AJMartel/Grove_LoRa_433MHz_and_915MHz_RF/Schematics/LoRa Radio 915MHz v1.0.brd

## EAGLE design Schematics/LoRa Radio 915MHz v1.0.brd (2019-04-16)

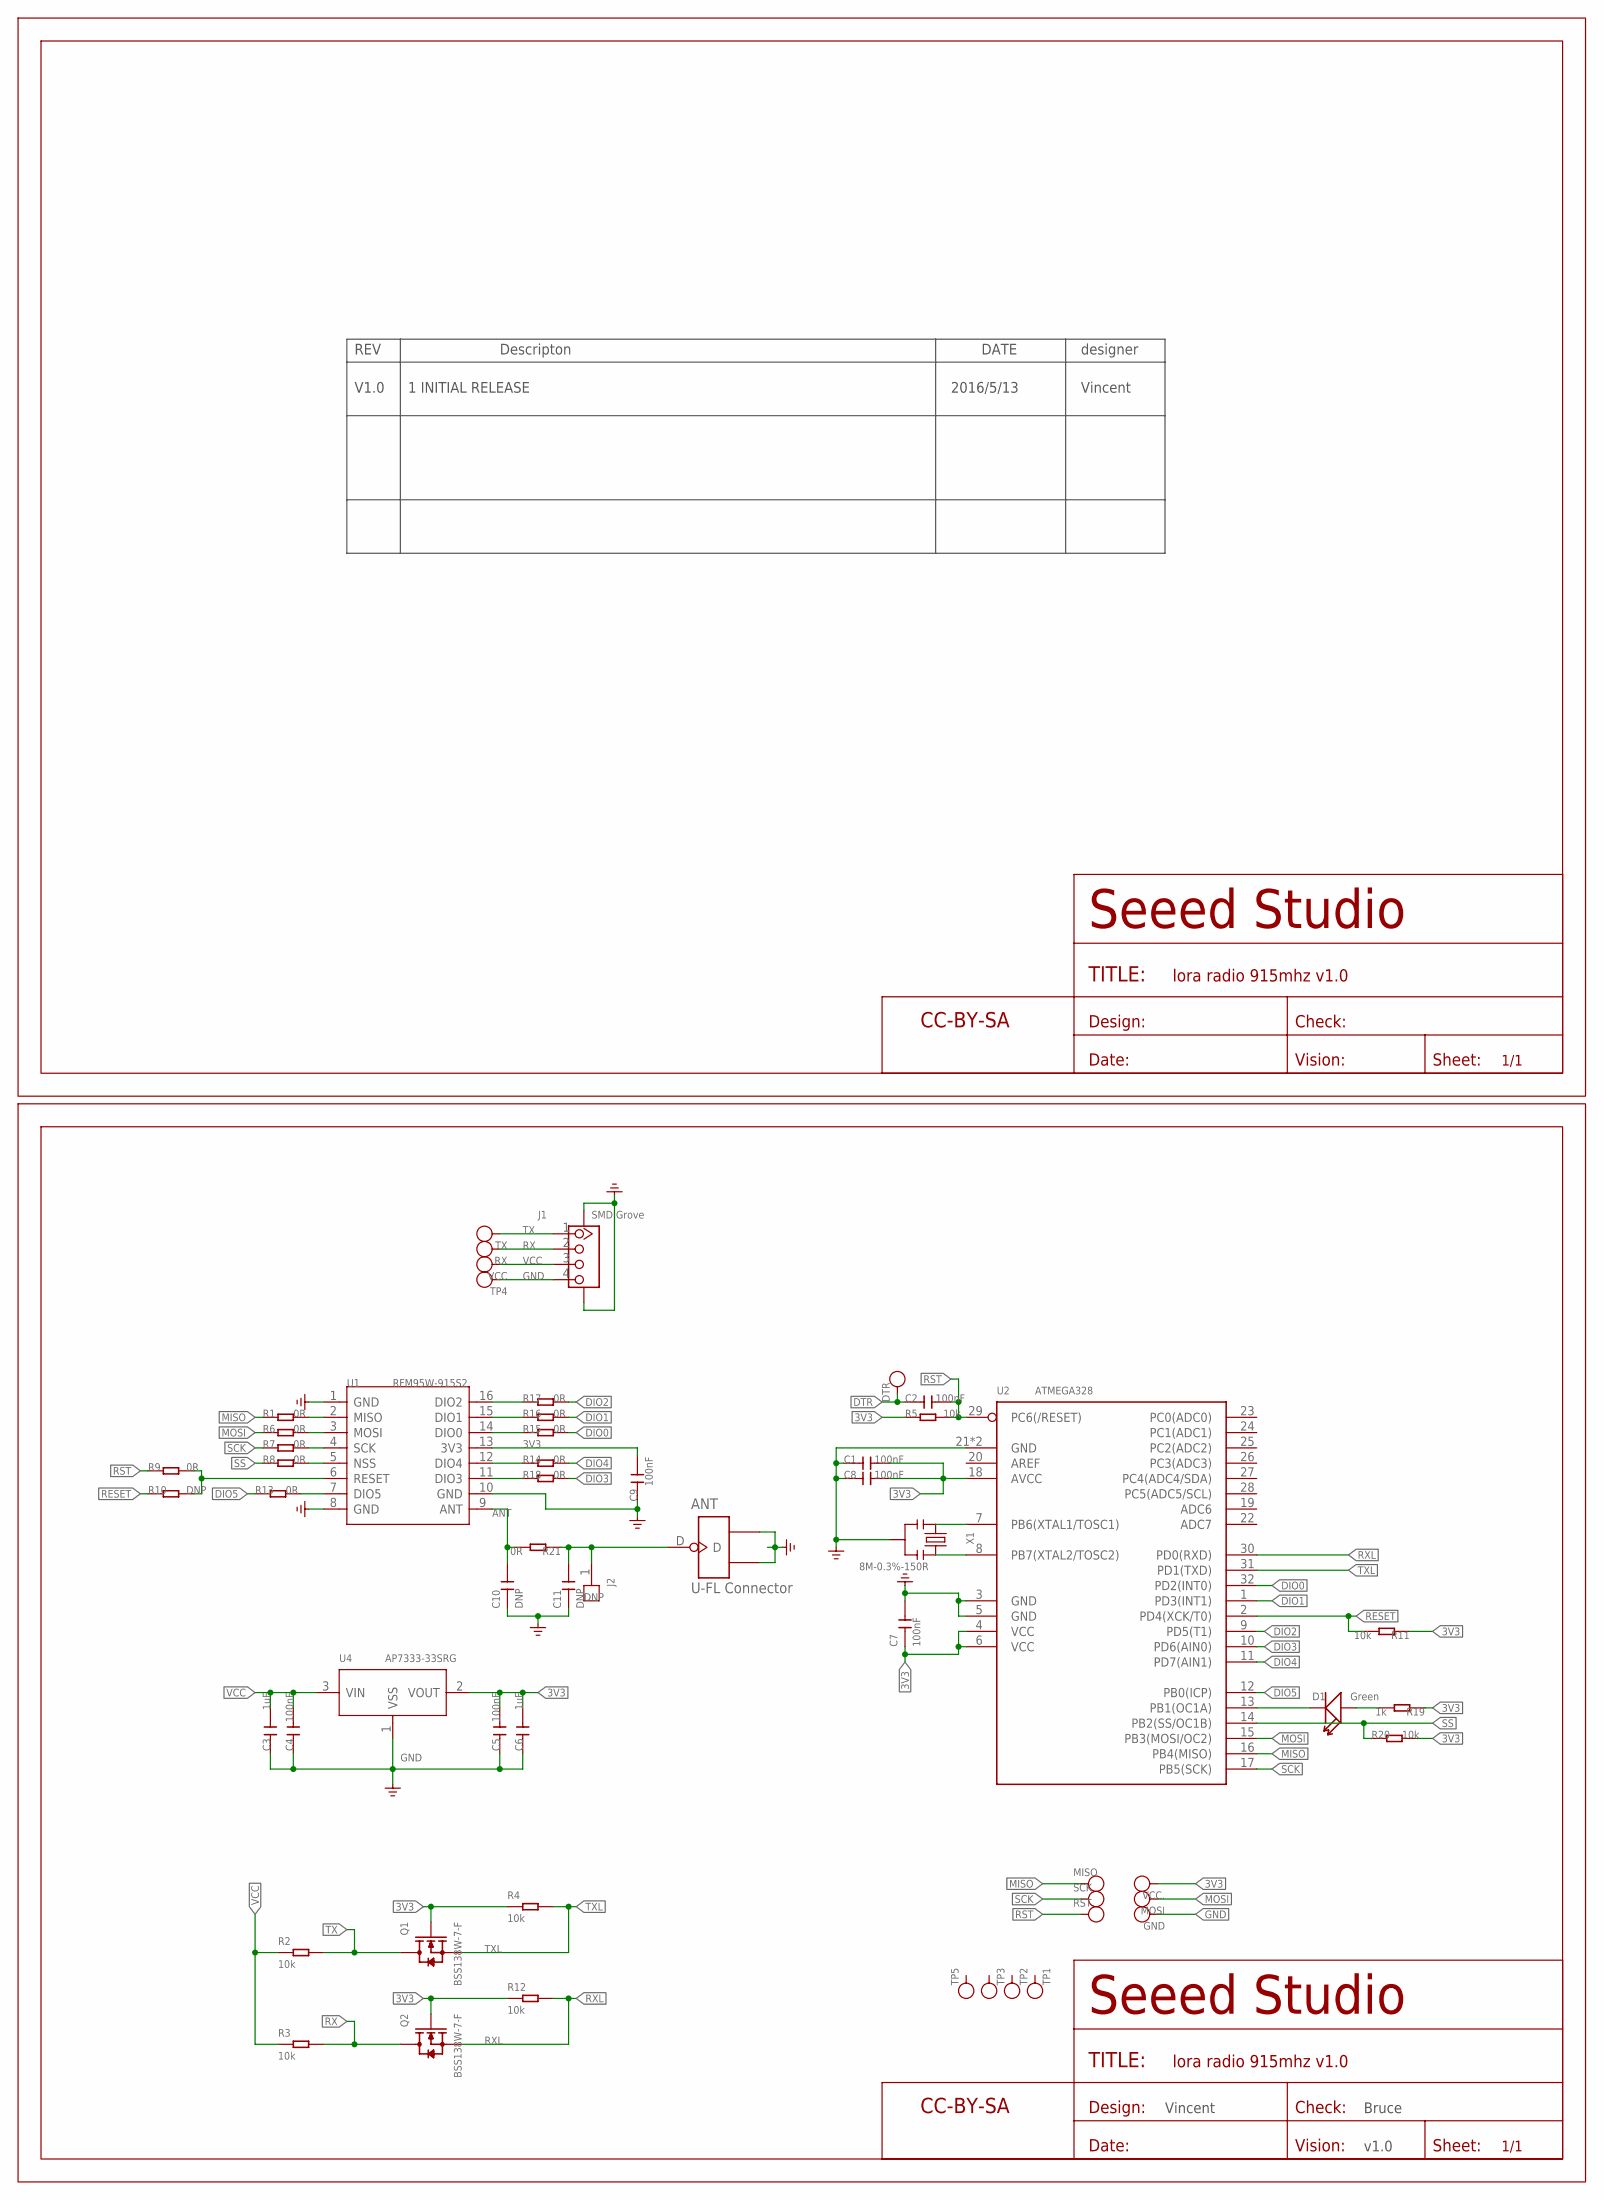
[picture p1: schematic LoRa Radio 915MHz v1.0.sch]

Parts:
ANT: U-FL Connector; U-FL3P-SMD-2.6X2.6X1.0MM
C1, C2, C4, C5, C7, C8, C9: 100nF; C0402
C3, C6: 1uF; C0402
C10, C11: DNP; C0402
D1: Green; LED-0402
DTR: TEST-POINT'4545'; TP-D45MIL
FR1, FR2: SEEEDSTUDIO-OPEN-SCH-FRAME; SEEEDSTUDIO-PCB-FRAME
GND: DNP; TP-D45MIL
J1: SMD Grove; HW4-SMD-2.0
J2: DNP; 1P-65/35MIL
MISO: DNP; TP-D45MIL
MOSI: DNP; TP-D45MIL
Q1, Q2: BSS138W-7-F; SOT-323
R1, R6, R7, R8, R9, R13, R14, R15, R16, R17, R18: 0R; R0402
R2, R3, R4, R5, R11, R12, R20: 10k; R0402
R10: DNP; R0402
R19: 1k; R0402
R21: 0R; R0603
RST: DNP; TP-D45MIL
RX: TEST-POINT'4545'; TP-D45MIL
SCK: DNP; TP-D45MIL
TP1, TP2, TP3, TP4, TP5: TEST-POINT'4545'; TP-D45MIL
TX: TEST-POINT'4545'; TP-D45MIL
U1: RFM95W-915S2; MODEM16-2-16X16X1.8MM
U2: ATMEGA328; QFN32G-0.5-5X5MM
U4: AP7333-33SRG; SOT-23
VCC: TEST-POINT'4545'; TP-D45MIL
VCC.: NC; TP-D45MIL
X1: 8M-0.3%-150R; RESONATOR3-SMD-3.6X1.3X0.8MM

Connections:
3V3: C1.2, C5.1, C6.1, C7.1, C8.2, C9.2, Q1.1 (G), Q2.1 (G), R4.1, R5.2, R11.2, R12.1, R19.2, R20.2, U1.13 (3V3), U2.4 (VCC), U2.6 (VCC), U2.18 (AVCC), U4.2 (VOUT), VCC..T
ANT: C10.2, R21.2, U1.9 (ANT)
DIO0: R15.2, U2.32 (PD2(INT0))
DIO1: R16.2, U2.1 (PD3(INT1))
DIO2: R17.2, U2.9 (PD5(T1))
DIO3: R18.2, U2.10 (PD6(AIN0))
DIO4: R14.2, U2.11 (PD7(AIN1))
DIO5: R13.1, U2.12 (PB0(ICP))
DTR: C2.1, DTR.T
GND: ANT.GND1, ANT.GND2, C1.1, C3.2, C4.2, C5.2, C6.2, C7.2, C8.1, C9.1, C10.1, C11.1, GND.T, J1.4, J1.SS1, J1.SS2, TP4.T, U1.1 (GND), U1.8 (GND), U1.10 (GND), U2.3 (GND), U2.5 (GND), U2.21 (GND), U2.33 (GND), U4.1 (VSS), X1.2
MISO: MISO.T, R1.1, U2.16 (PB4(MISO))
MOSI: MOSI.T, R6.1, U2.15 (PB3(MOSI/OC2))
unnamed: R13.2, U1.7 (DIO5)
unnamed: R17.1, U1.16 (DIO2)
unnamed: R9.1, R10.1, U1.6 (RESET)
unnamed: R16.1, U1.15 (DIO1)
unnamed: R15.1, U1.14 (DIO0)
unnamed: R14.1, U1.12 (DIO4)
unnamed: R1.2, U1.2 (MISO)
unnamed: R6.2, U1.3 (MOSI)
unnamed: R7.2, U1.4 (SCK)
unnamed: R8.2, U1.5 (NSS)
unnamed: R18.1, U1.11 (DIO3)
unnamed: D1.-, U2.13 (PB1(OC1A))
unnamed: D1.+, R19.1
unnamed: ANT.D, C11.2, J2.1, R21.1
RESET: R10.2, R11.1, U2.2 (PD4(XCK/T0))
RST: C2.2, R5.1, R9.2, RST.T, U2.29 (PC6(/RESET))
RX: J1.2, Q2.3 (D), R3.2, RX.T
RXL: Q2.2 (S), R12.2, U2.30 (PD0(RXD))
SCK: R7.1, SCK.T, U2.17 (PB5(SCK))
SS: R8.1, R20.1, U2.14 (PB2(SS/OC1B))
TX: J1.1, Q1.3 (D), R2.2, TX.T
TXL: Q1.2 (S), R4.2, U2.31 (PD1(TXD))
VCC: C3.1, C4.1, J1.3, R2.1, R3.1, U4.3 (VIN), VCC.T
XTAL1: U2.7 (PB6(XTAL1/TOSC1)), X1.1
XTAL2: U2.8 (PB7(XTAL2/TOSC2)), X1.3

Notes on the sheet:
REV
Descripton
DATE
designer
V1.0
1 INITIAL RELEASE
2016/5/13
Vincent
Bruce
v1.0

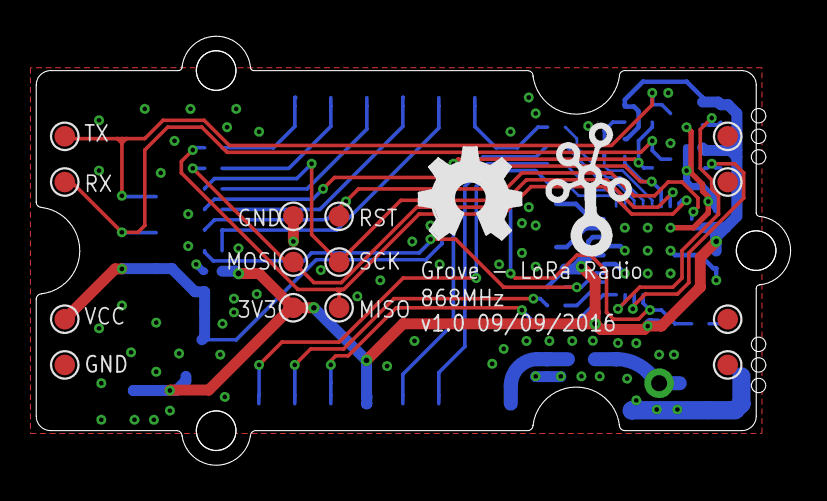
[picture p2: board LoRa Radio 915MHz v1.0.brd from above]

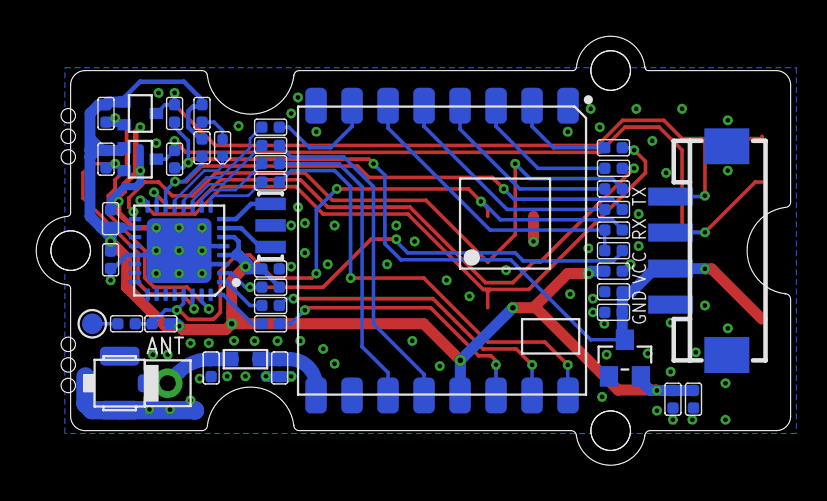
[picture p3: board LoRa Radio 915MHz v1.0.brd from below]

Board: 2 copper layers, 41.9 x 23.8 mm, 62 parts (46 on the bottom side), 37 nets.

Other parts of the board:
U$2: OSHW_FILLX200_NOTEXT
U$4: GROVE-1*2-TEST-PLATFORM-TOP
U$8: GROVE-SILK-BIG
